MKEadmin/Vertical_farming/pcb/readme.md

Here you can find the pcb schemetics and gerber files for the Vertical Farming PCB.
