MKEadmin/Vertical_farming/Documents/STORYS.docx

STORYS

Docent

Als | Wil ik | Omdat
Docent | In python programmeren | We in de lessen alleen python gebruiken
Docent | Alles in Github | Ik overzicht wil wat de laatste versie is van de producten.
Docent | Een Planning in Trello | Het op school veel gebruikt wordt
Docent | Een werkende of deels werkende broei kast | Dat het doel van het project is
Docent | Trello gebruiken | Ik wil weten wie met wat bezig is, en wat je al af hebt

Leerling

Als | Wil ik | Omdat
Leerling | Reële opdrachten | Ik een succesvol wil afronden
Leerling | Uitdaging | Ik wil leren programmeren
Leerling | Programmering overzichtelijk hebben staan | Ik wil dat anderen de programmering kunnen inzien en veranderen
Leerling | Informatie over het project | We willen weten wat het project moet doen en waar het voor staat
Leerling | Duidelijke afspraken en communicatie | Chaos frustrerend is.
Leerling | Ruime en tijd krijgen voor het project | Ik er anders naast de lessen er niet aan kan/ mag werken
Leerling | Trello gebruiken | Ik wil weten wie met wat bezig is, en wat je al af hebt

Gebruiker

Als | Wil ik | Omdat
Gebruiker | Data online afkunnen lezen op mijn telefoon, tablet of PC | Als er te veel mensen bij de kast staan. Nog steeds eraan kunnen werken en het gebruiken
Gebruiker | Dat het water en andere aspecten vanzelf aan gaan als ik dichtbij kom of als het tijd is | Je niet op elk moment aanwezig bent en doordoor niet
Gebruiker | Een knop om alles meteen zonder spanning te zetten (Noodknop) | Ik het belangrijk vind om veilig te werken
Gebruiker | dat de algemene status van het apparaat uitgelezen kan worden | dit handig is voor: testen, documentatie en overzichtelijkheid
Gebruiker | dat het device gebruiksvriendelijk is | het product anders niet efficiënt is.
Gebruiker | Mooi/ duidelijk interface | Ik goed de status wil bekijken

Bezoeker

Als | Wil ik | Omdat
Bezoeker | Een mooie en overzichtelijke broei kas | Ik het belangrijk vind dat het er mooi en overzichtelijk uitziet
Bezoeker | Een overzichtelijke display met informatie (Data) | Ik wil gestructureerd kunnen aflezen van informatie
Bezoeker | Verzorgde uitstraling | Ik een goede indruk wil krijgen van het product

Plant

Bezoeker

Als | Wil ik | Omdat
Plant | Een goede groei omgeving | Ik sterk en gezond wil groeien
