MKEadmin/Vertical_farming/EDUTRANS Part List Vertical Farming.xlsx

 |  | PART LIST
Model: | M1
Desctiption: | Vertical Farming
School: | Da Vinci College
NUMBER | NAME | DRAWING NAME | QTY | AUTHOR | COMMERCIAL REF. | DESCRIPTION | Website | Cost
1 | Alu profile | part of assembly | 16 | DVC | 222-000 | BSB 30x30N L= 2000 mm | https://www.tech-specialist.com/nl/ | €300.00
2 | BSB 8 Central connector 90 | NA | 32 | commercial | 1007723 | BSB 8 Central connector 90 degrees | https://www.tech-specialist.com/nl/ | €64.00
3 | BSB 8 Central connector 0 | NA | 32 | commercial | 1007719 | BSB 8 Central connector 0 degrees | https://www.tech-specialist.com/nl/ | €64.00
4 | BSB T-slot snap-in nut steel with cam and leaf spring | NA | 60 | commercial | 1008412 | BSB T-slot snap-in nut steel with cam and leaf spring | https://www.tech-specialist.com/nl/ | €120.00
5 | BSB Corner block connector incl. cap | NA | 8 | commercial | 1024293 | BSB Corner block connector incl. cap | https://www.tech-specialist.com/nl/ | €68.00
6 | BSB clamping rubber | NA | 200m | commercial | 1019322 | BSB clamping rubber | https://www.tech-specialist.com/nl/ | €200.00
7 | BSB Plastic Hinge | NA | 8 | commercial | 1008598 | BSB Plastic Hinge | https://www.tech-specialist.com/nl/ | €25.00
8 | Wheel Swivel | NA | 2 | Blickle | 294926 | Swivel castors with polyurethane tread with brake | https://www.blickle.nl/ | €70.00
9 | Fixed-wheel | NA | 2 | Blickle | 297119 | Fixed-wheel castor with polyurethane tread | https://www.blickle.nl/ | €35.00
10 | Knob | NA | 8 | random | 3036-S | M8x1,25 internal thread | NA | €32.00
11 | Polucarbonaat sheets 5 mm | part of assembly | 16 m2 | random | NA | clear and white, shape and size acc.to drawings | NA | €960.00
12 | Mist Nozzles | NA | 8 | Ounona by Amazon | B07DRFZWYW | Adjustable sprinkler, copper, with capillary effect | https://www.amazon.nl/Verstelbare-sproeikoper-capillaire-instelbare-druppelsysteem/dp/B07DRFZWYW | €16.00
13 | Hose 8 and 12 mm | NA | 2 x 50 m | commercial | NA | water hose for nozzles | NA | €175.00
14 | Connectors for waterhose | NA | 50 | commercial | NA | connectors 8 en 12 mm, collection | highly available on the internet | €150.00
15 | Shut-off valve | NA | 8 | Festo | HE-2-QS-8 | connector with shut-off function | www.festo.com | €90.00
16 | Main valve | NA | 1 | JP Fluid Control | ST-SA012B105F-012DC | Electric Solenoid Valve, G 1/2 " 12V NC Copper | https://tameson.nl/kleppen/magneetventiel/2-weg/messing/st-sa012b105f-012dc-magneetventiel-2weg-012inch-messing-0p0-10bar-fkm.html | €47.00
17 | Valve 2-2 per layer | NA | 4 | Acogedor by Amazon | 747333445732 | Electric Solenoid Valve, G 1 / 2" 12V NC plastic | https://www.amazon.nl/Valve%EF%BC%8CMagneetventiel%EF%BC%8Celektrisch-magneetventiel-kunststof-elektrisch-waterafgifte/dp/B07Q5ZZBWK | €36.00
18 | pressure gauge | NA | 1 | commercial | NA | Pressure cauge 0-10 bar | highly available on the internet | €15.00
19 | LED Tube | NA | 4 | Hortilight | LT-KVHL30LT | 30W waterproof LED Tube Grow | https://www.kweekverlichting.nl/led-kweeklampen/strips/led-tube-30w-bloei | €360.00
20 | Axial fan | NA | 4 | Farnel | MC001616 | Axial Fan, IP68, 12 V, DC, 80 mm, 25 mm, 41 cu.ft/min, 69.7 m³/h | https://nl.farnell.com/multicomp/mc001616/axial-fan-80mm-12vdc-41cfm-33dba/dp/2759177 | €86.00
21 | Cable glands etc for electrical wirering | NA | 30 | commercial | several types | for hoses to keep it watertight | highly available on the internet | €30.00
22 | Arduino 1 | NA | 1 | commercial | Arduino 1 | controler | highly available on the internet | €25.00
23 | Wifi receiver | NA | 1 | commercial | Arduino-esp8266 | to communicate with the www | highly available on the internet | €4.00
24 | Adafruit Proto Screw Shield | NA | 1 | commercial | NA | to add to Arduino | https://www.kiwi-electronics.com/en/adafruit-proto-shield-for-arduino-kit-stackable-version-r3-2568 | €11.00
25 | Relais module for Arduino | NA | 1 | commercial | TRU COMPONENTS TC-9445344 | 16 relais on 1 board | highly available on the internet | €30.00
26 | Power supply | NA | 1 | commercial | NA | Power Supply 12V DC 150W 15A | highly available on the internet | €20.00
27 | Gas sensor | NA | 1 | commercial | MQ-135 | to messure Carbon Dioxide | highly available on the internet | €5.00
28 | Temp and Humidity sensor | NA | 1 | commercial | DHT22 | to messure Temp and Humidity | highly available on the internet | €9.00
29 | Display | NA | 1 | Nextion | NX4024T032 | display 3,2 inch | NX4024T032 (IM150416005) (https://www.itead.cc/nextion-nx4024t032.html) | €45.00
 |  |  |  |  |  |  | Total | €3092.00
