MKEadmin/Vertical_farming/case/vf-case.3mf

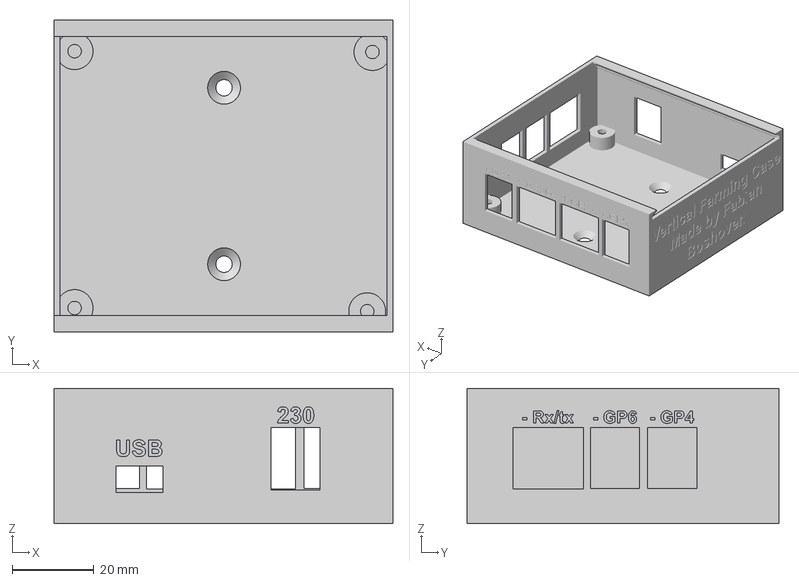
[picture p2: CAD file, 2023-11-05]
case/vf-case.3mf
82.7 x 76.1 x 33.0 mm
