MKEadmin/Vertical_farming/case/lidv1.3mf

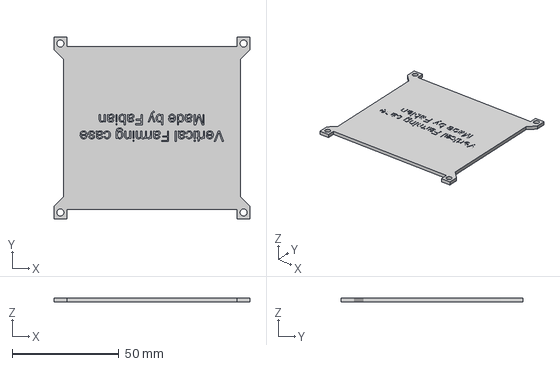
[picture p3: CAD file, 2023-11-05]
case/lidv1.3mf
91.7 x 85.1 x 2.00 mm
