MKEadmin/Vertical_farming/(list of files, cad)

Other CAD files:
pcb/Vertical_farming_pcb.f3z
