MKEadmin/Vertical_farming/pcb/Schematic v17.pdf

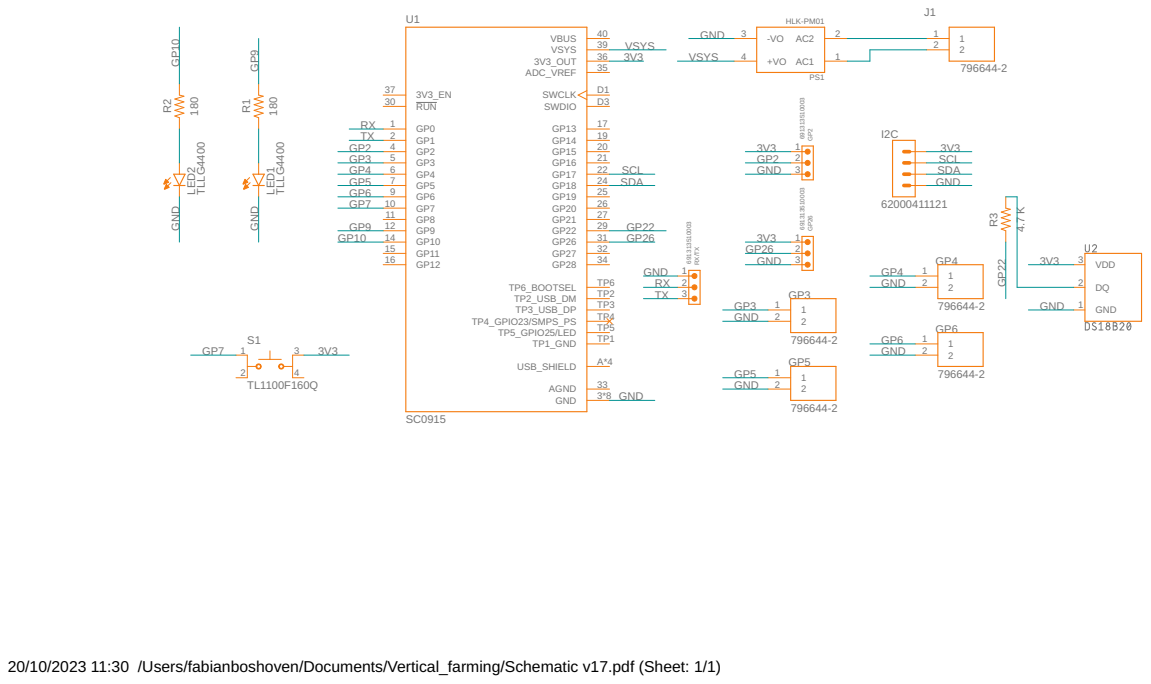
[picture p4: page 1]

20/10/2023 11:30 /Users/fabianboshoven/Documents/Vertical_farming/Schematic v17.pdf (Sheet: 1/1)
