MKEadmin/Vertical_farming/e-plan tekeningen v2.pdf

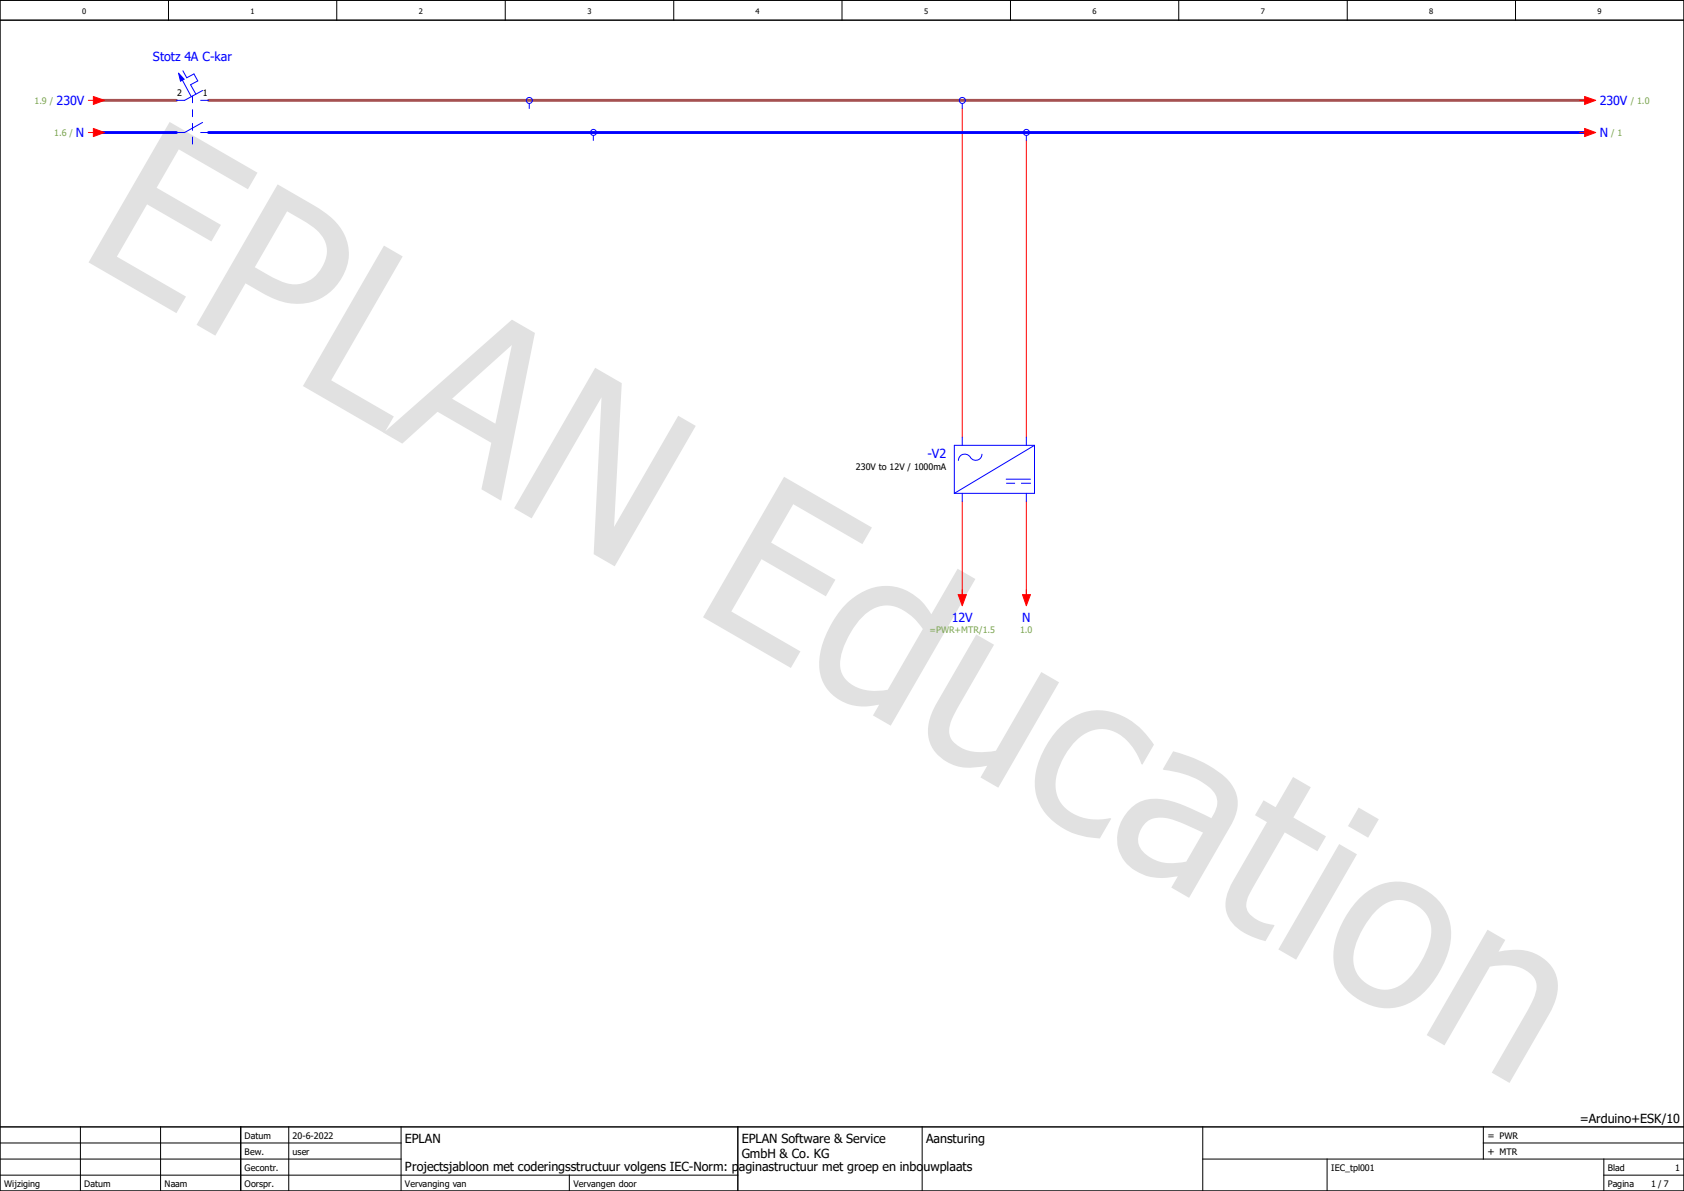
[picture p5: page 1]
=Arduino+ESK/10; Stotz 4A C-kar; 12V =PWR+MTR/1.5

20-6-2022 | EPLAN Projectsjabloon met coderingsstructuur volgens IEC-Norm: paginastructuur met groep en inbouwplaats | EPLAN Software & Service GmbH & Co. KG | Aansturing | = PWR

Bew. | user | | | | + MTR
Gecontr. | | | | | IEC_tpl001 | Blad

Wijziging | Datum | Naam | Oorspr. | | Vervanging van | Vervangen door | | | | Pagina 1 / 7

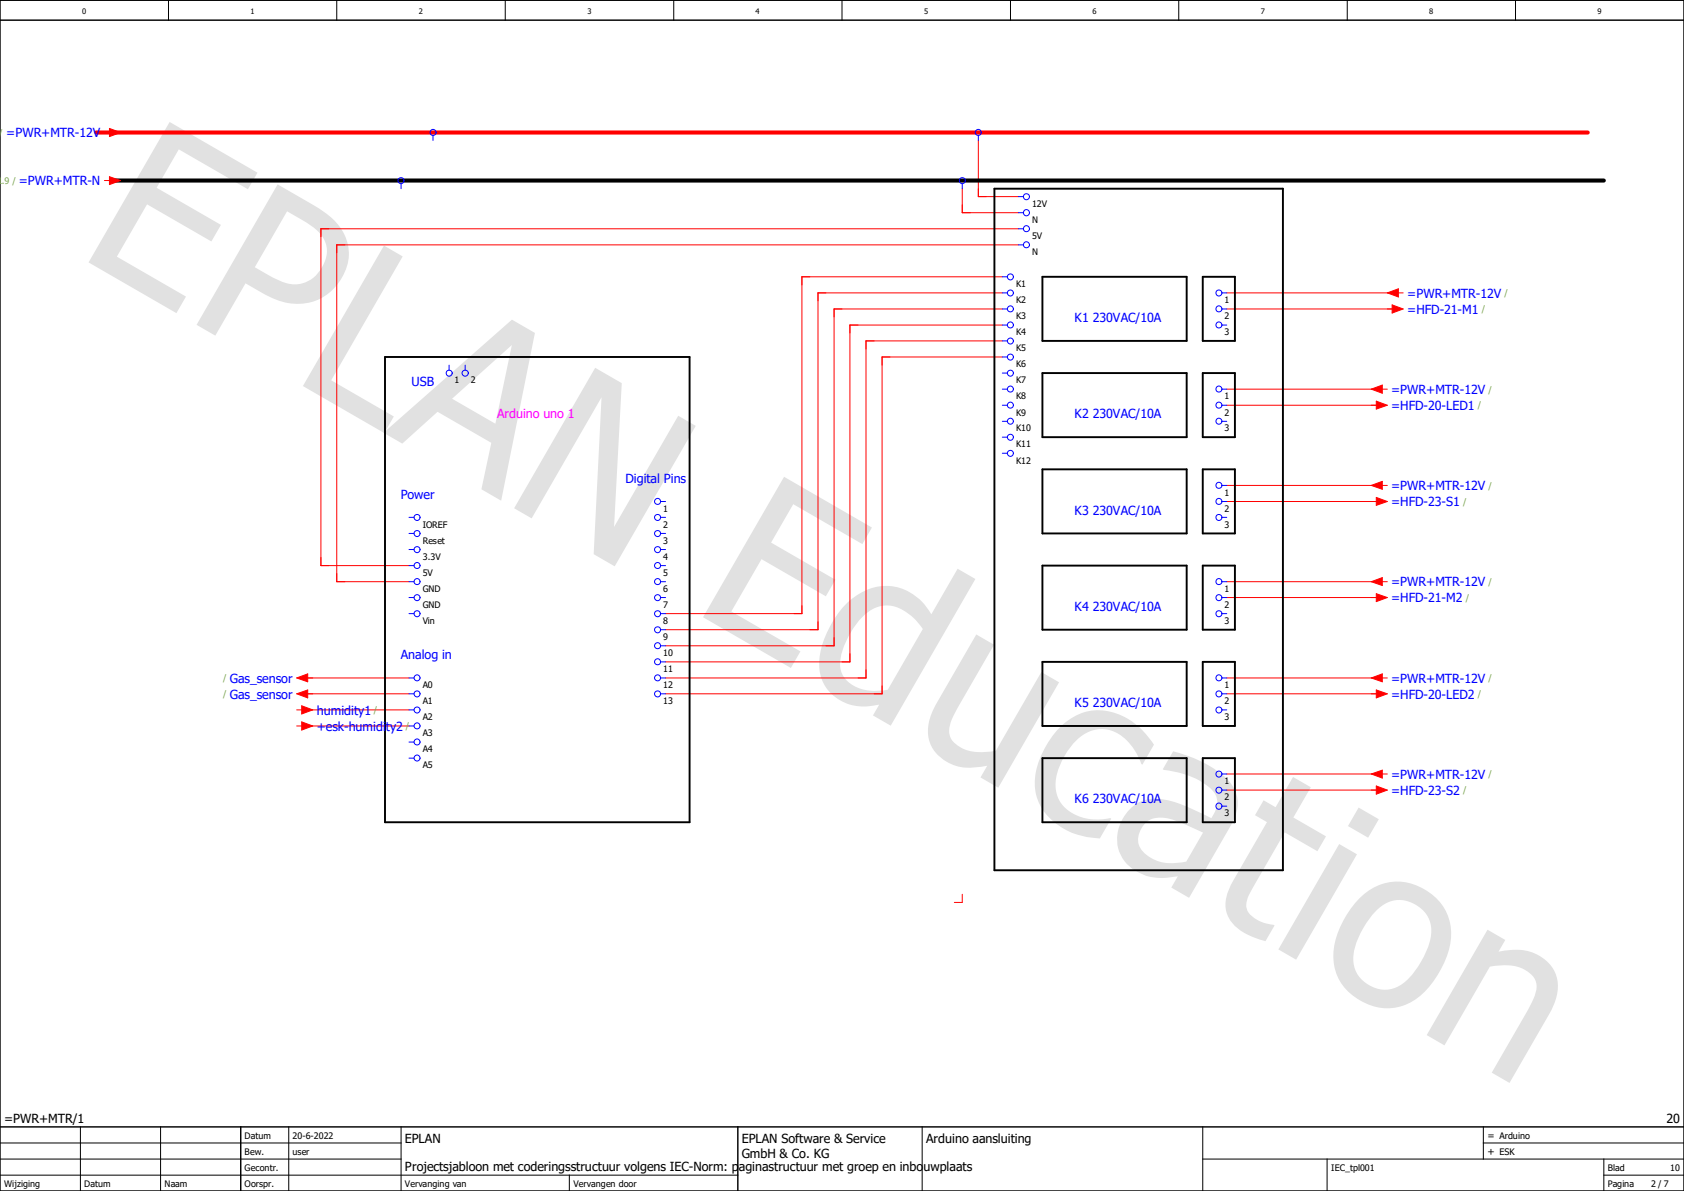
[picture p6: page 2]
=PWR+MTR/1; Arduino ESK; Arduino aansluiting; K1 230VAC/10A; K2 230VAC/10A; K3 230VAC/10A; K4 230VAC/10A; Digital Pins; Analog in; Power; K5 230VAC/10A; K6 230VAC/10A; Arduino uno 1; USB; IOREF Reset 3.3V 5V GND GND Vin; / =PWR+MTR-12V; / =PWR+MTR-N; =PWR+MTR-12V /; / Gas_sensor / Gas_sensor; =HFD-21-M1 /; =HFD-20-LED1 /; =HFD-23-S1 /; =HFD-21-M2 /; =HFD-20-LED2 /; =HFD-23-S2 /; +esk-humidity2 /; humidity1 /

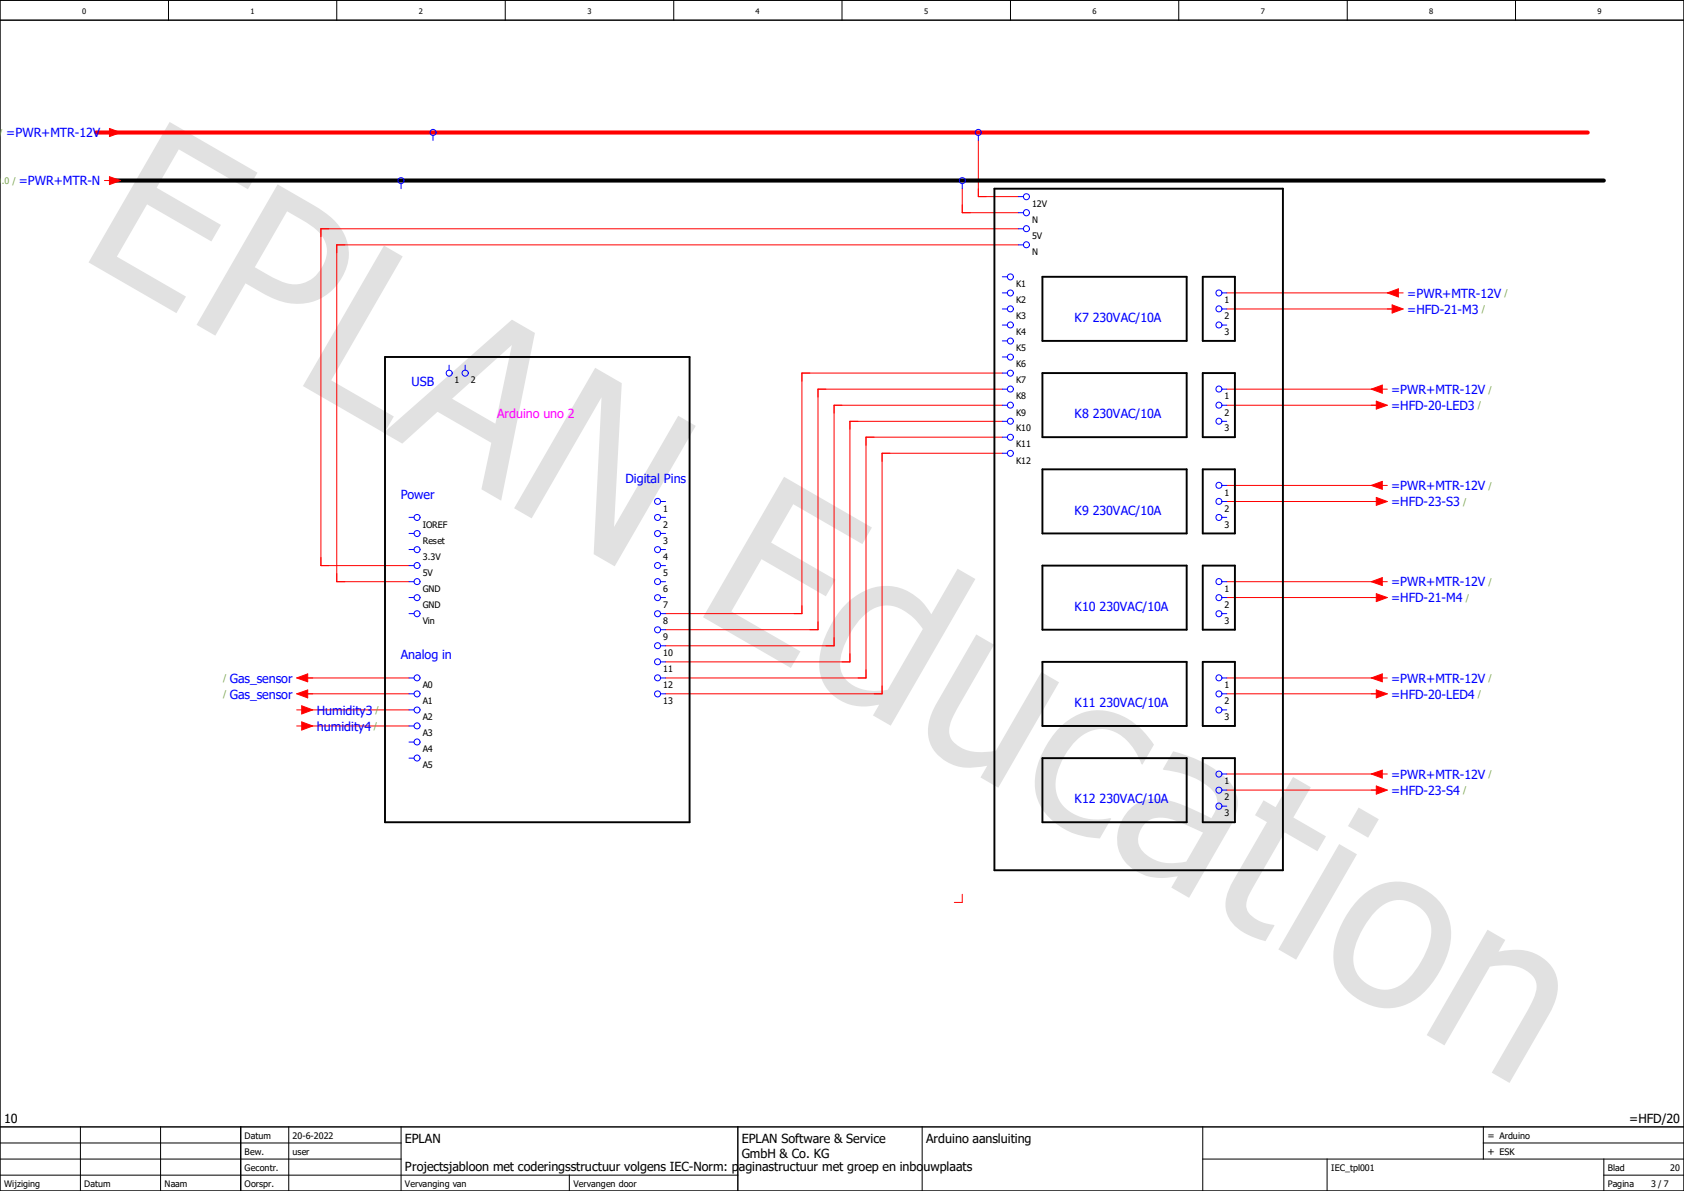
[picture p7: page 3]
Arduino; Arduino aansluiting; =HFD/20; K7 230VAC/10A; K8 230VAC/10A; K9 230VAC/10A; K10 230VAC/10A; Digital Pins; Analog in; Power; K11 230VAC/10A; K12 230VAC/10A; Arduino uno 2; USB; IOREF Reset 3.3V 5V GND GND Vin; / =PWR+MTR-12V; / =PWR+MTR-N; =PWR+MTR-12V /; / Gas_sensor / Gas_sensor; =HFD-21-M3 /; =HFD-20-LED3 /; =HFD-23-S3 /; =HFD-21-M4 /; =HFD-20-LED4 /; =HFD-23-S4 /; humidity4 /; Humidity3 /

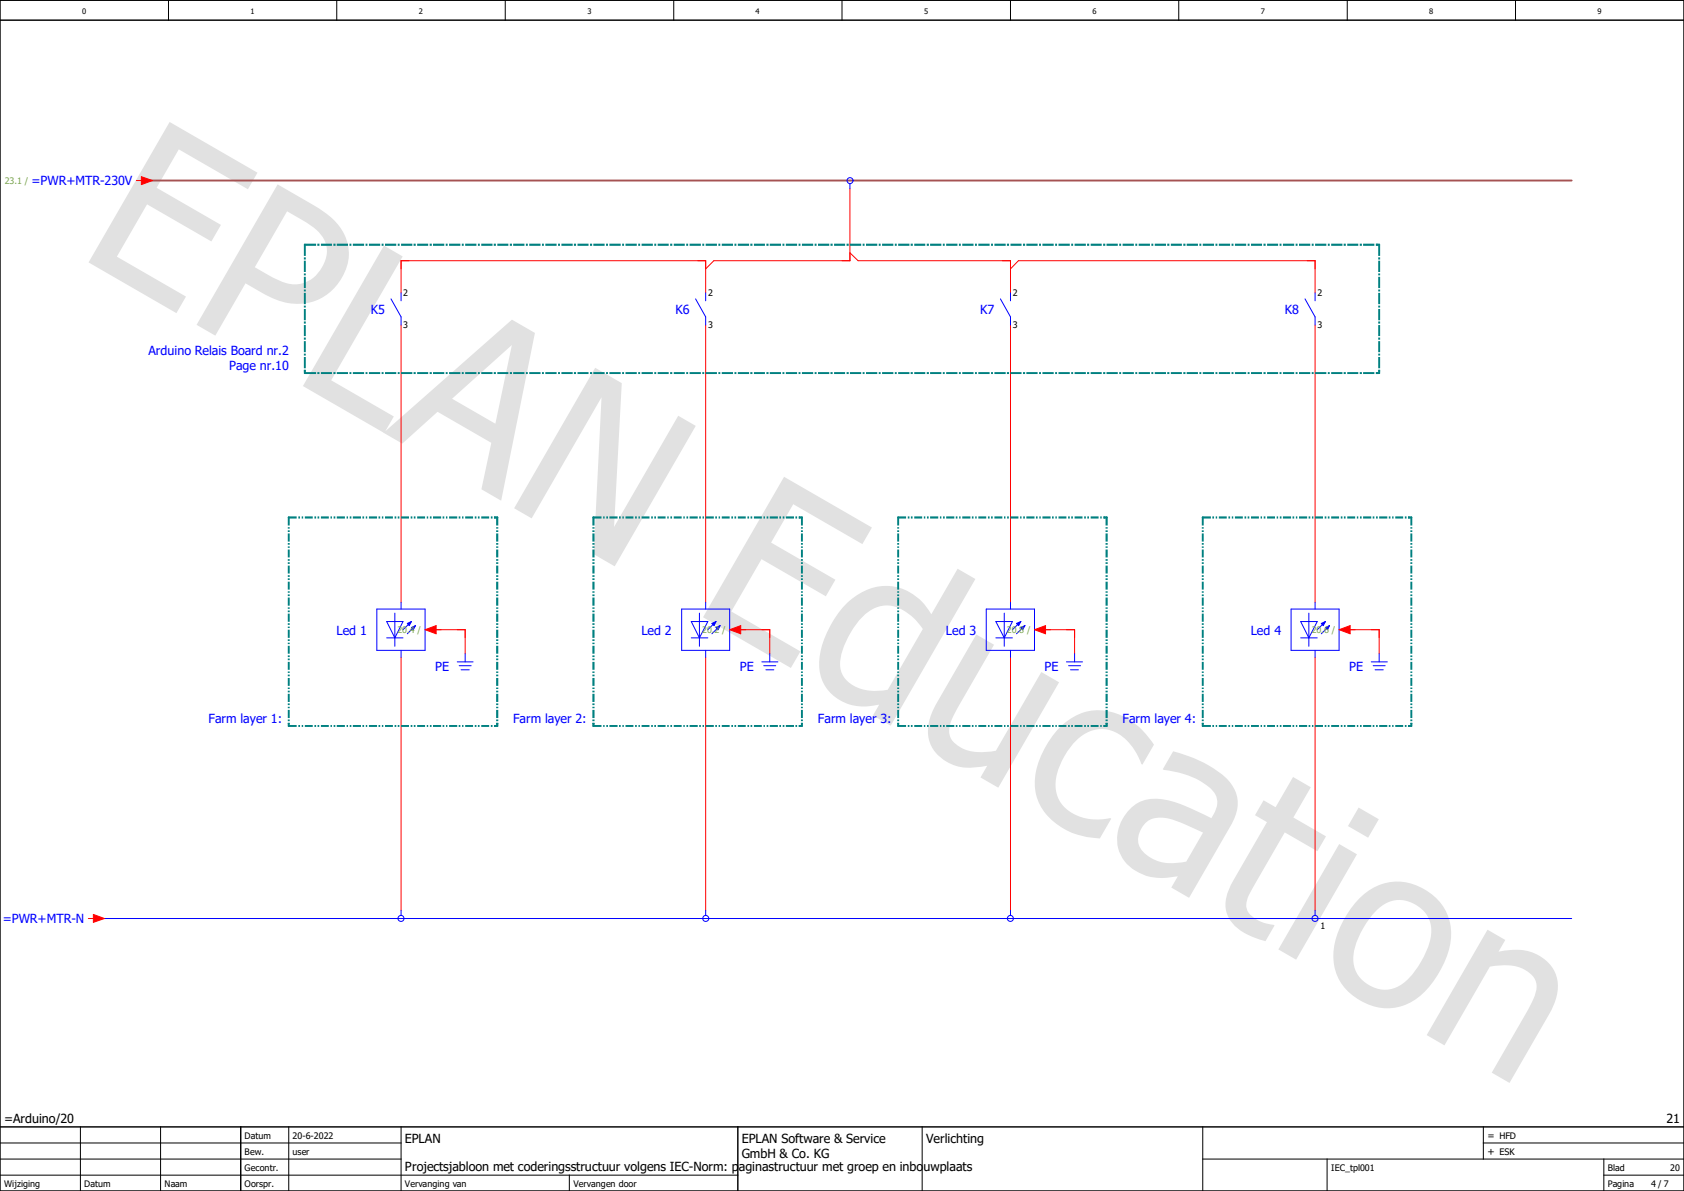
[picture p8: page 4]
=Arduino/20; HFD; Verlichting; Page nr.10; Farm layer 1:; Farm layer 2:; Farm layer 3:; Farm layer 4:; Led 1; Led 2; Led 3; Led 4; =PWR+MTR-N; 23.1 / =PWR+MTR-230V

Arduino Relais Board nr.2

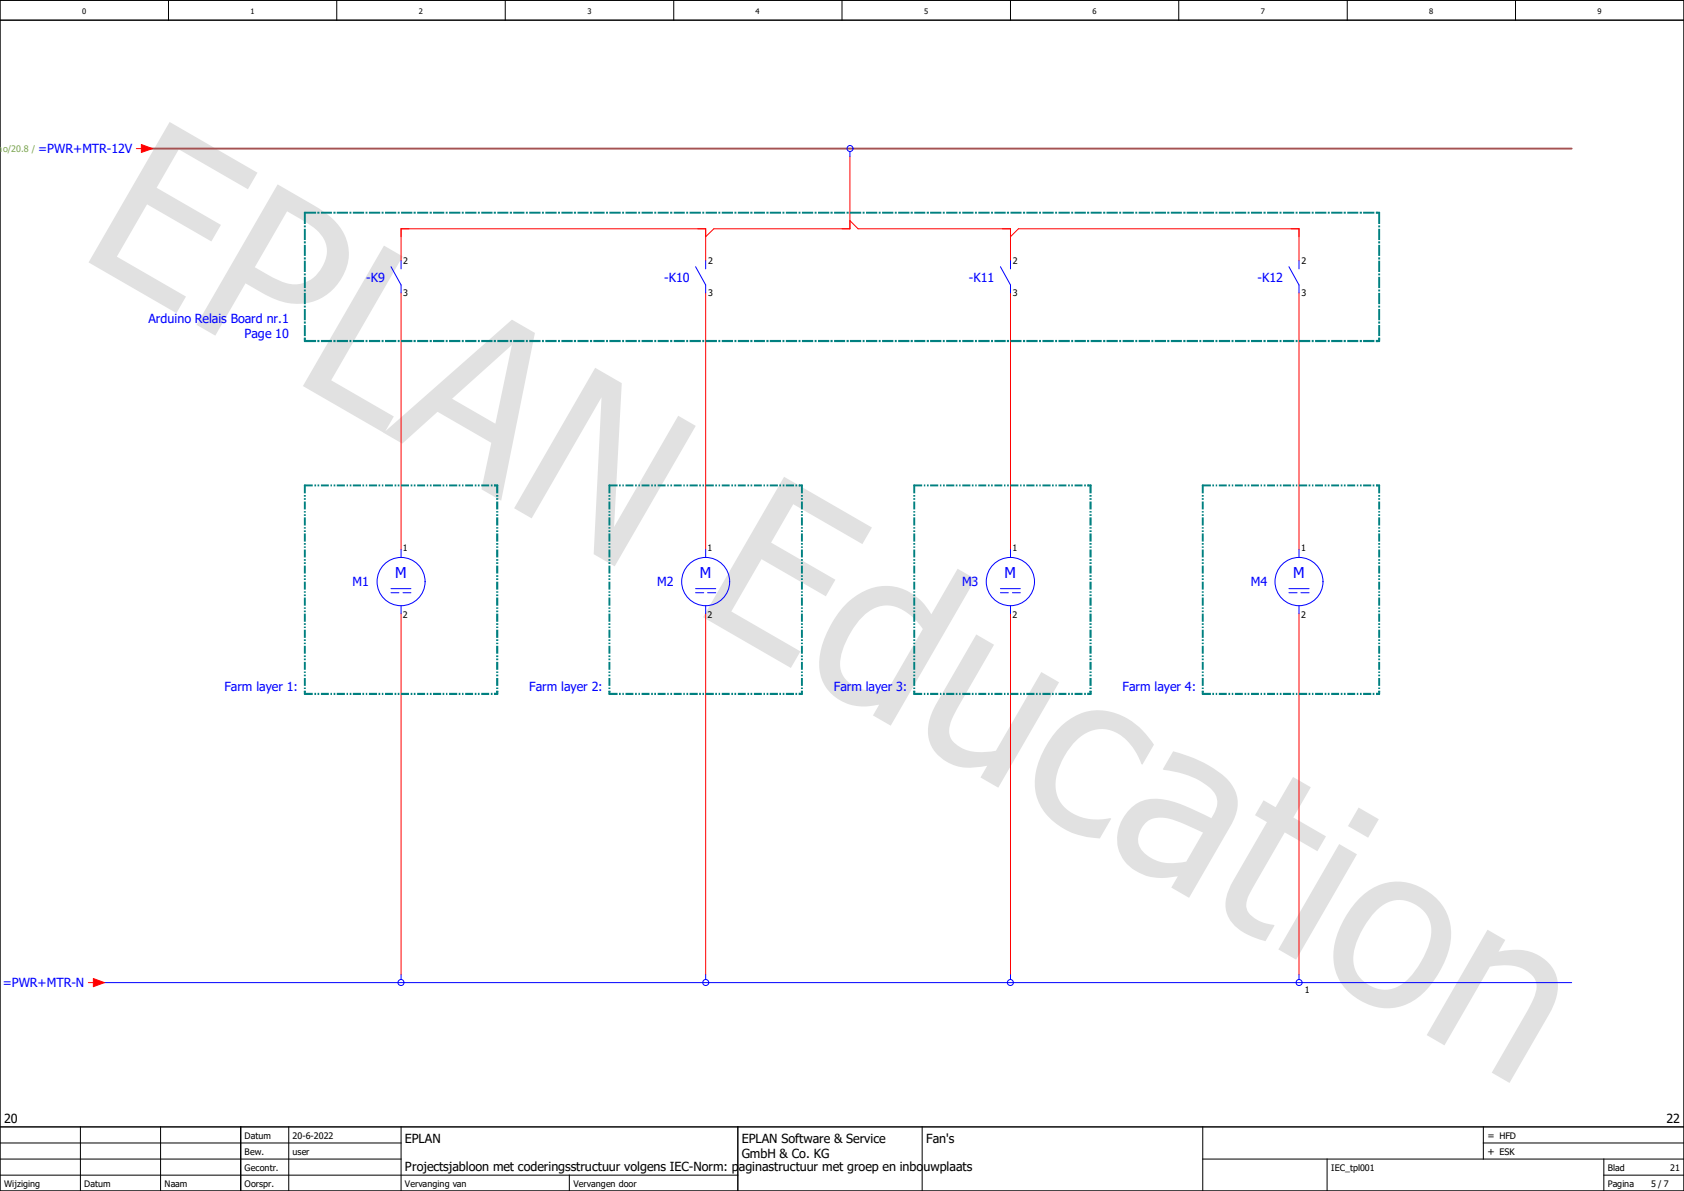
[picture p9: page 5]
Fan's; Page 10; Farm layer 1:; Farm layer 2:; Farm layer 3:; Farm layer 4:; =PWR+MTR-N; / =PWR+MTR-12V

Arduino Relais Board nr.1

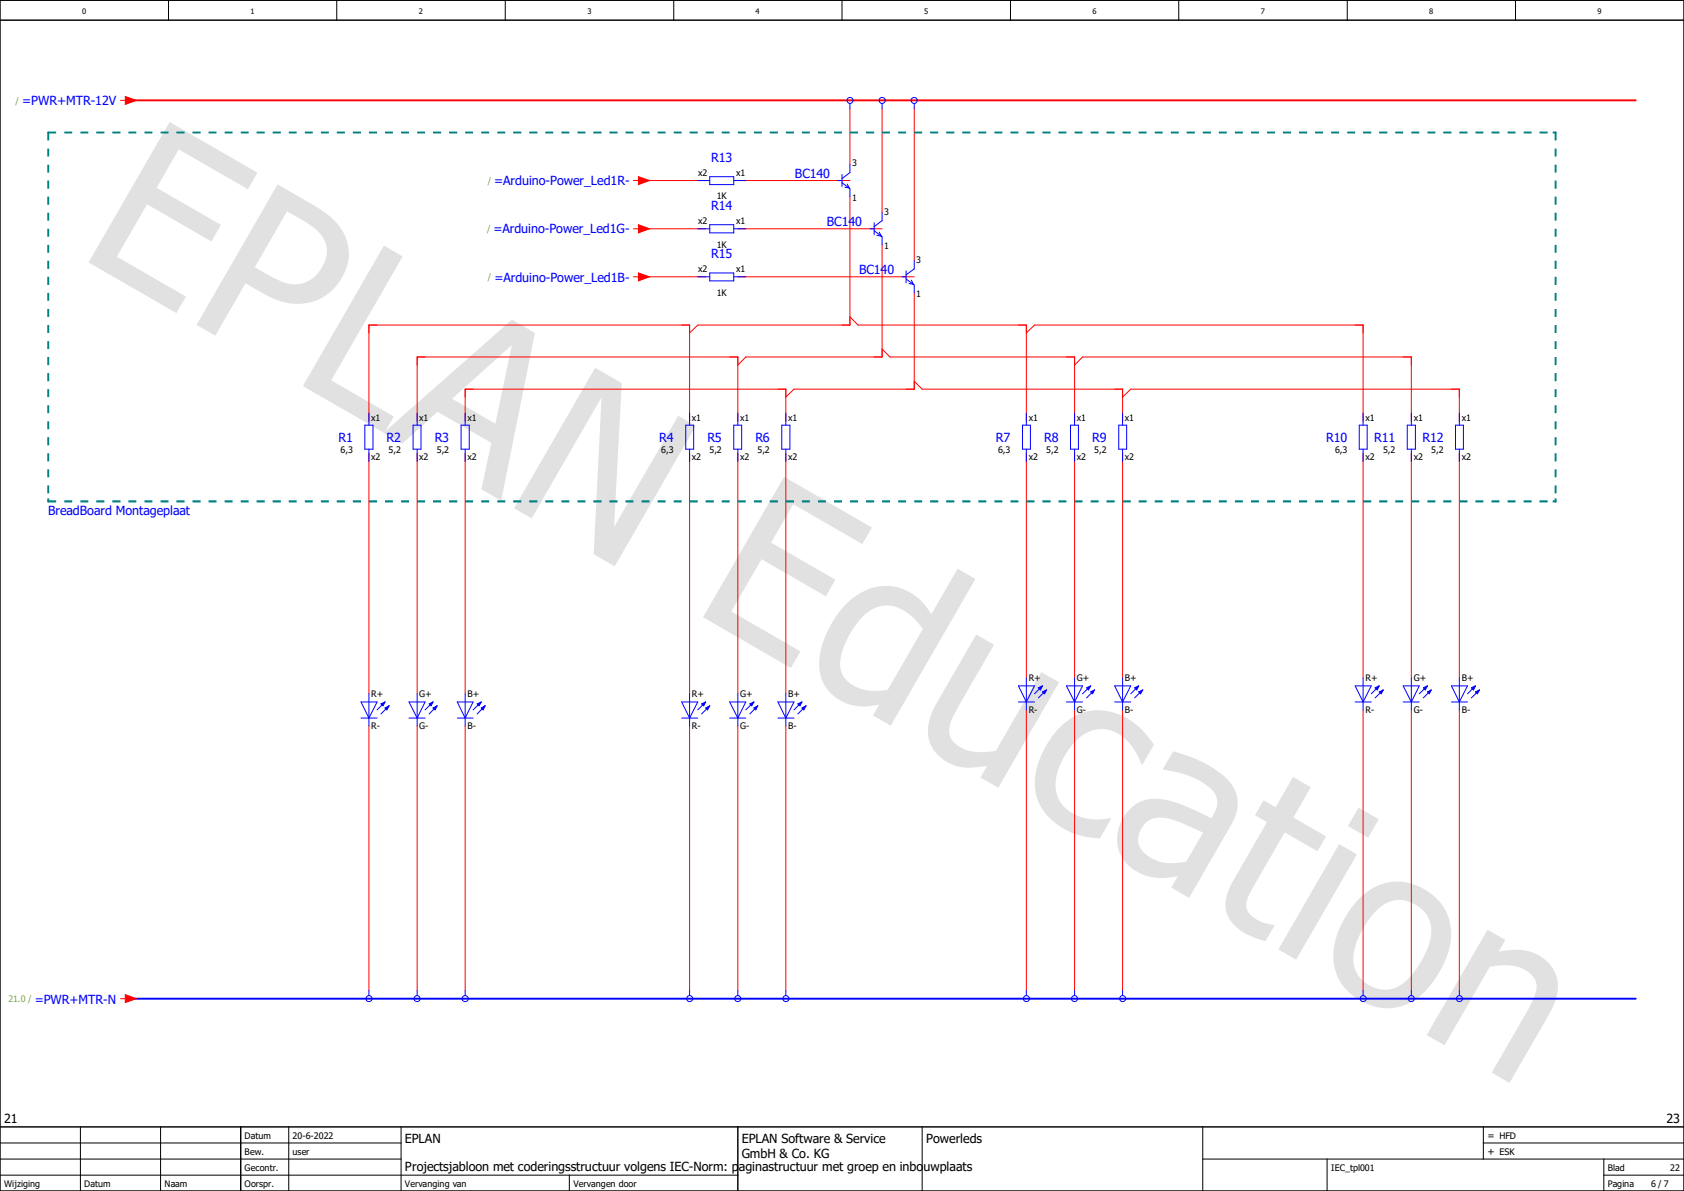
[picture p10: page 6]

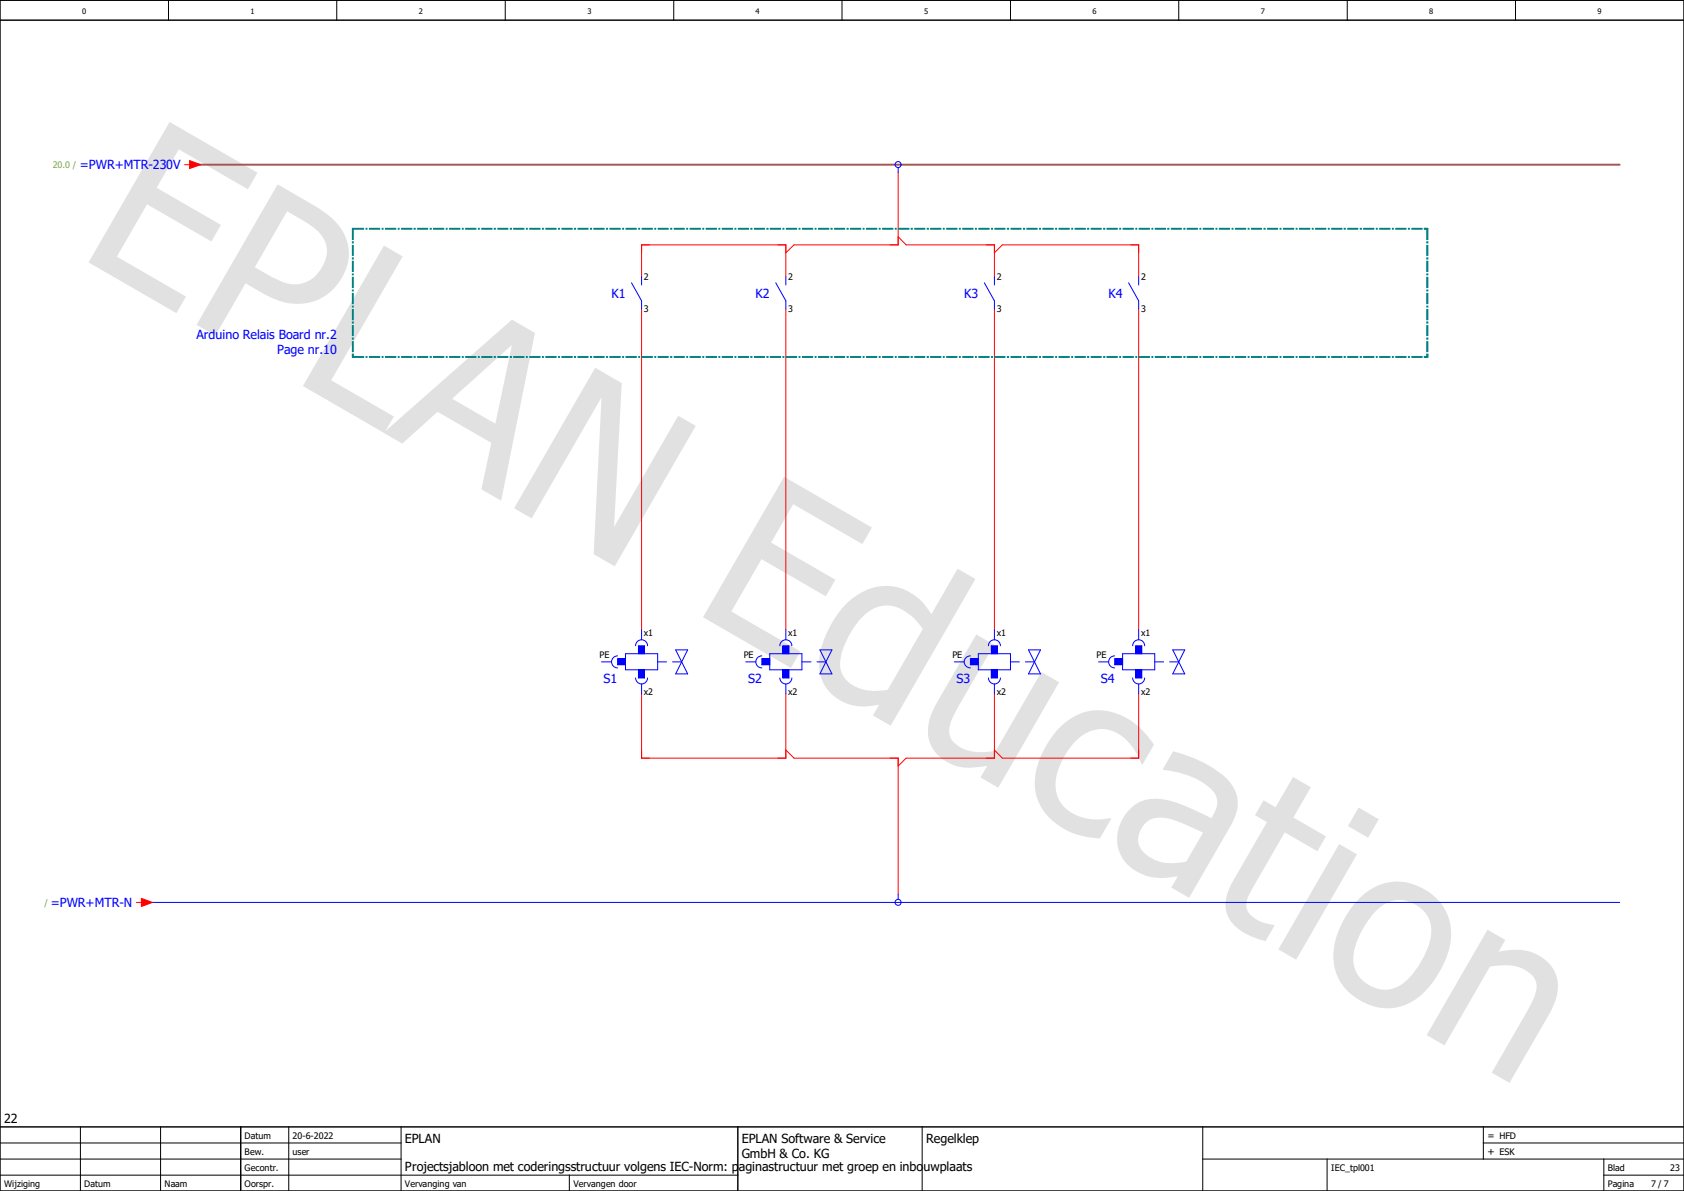
[picture p11: page 7]
Regelklep; Page nr.10; / =PWR+MTR-N; 20.0 / =PWR+MTR-230V

Arduino Relais Board nr.2
