MKEadmin/Vertical_farming/E-plan tekeningen.pdf

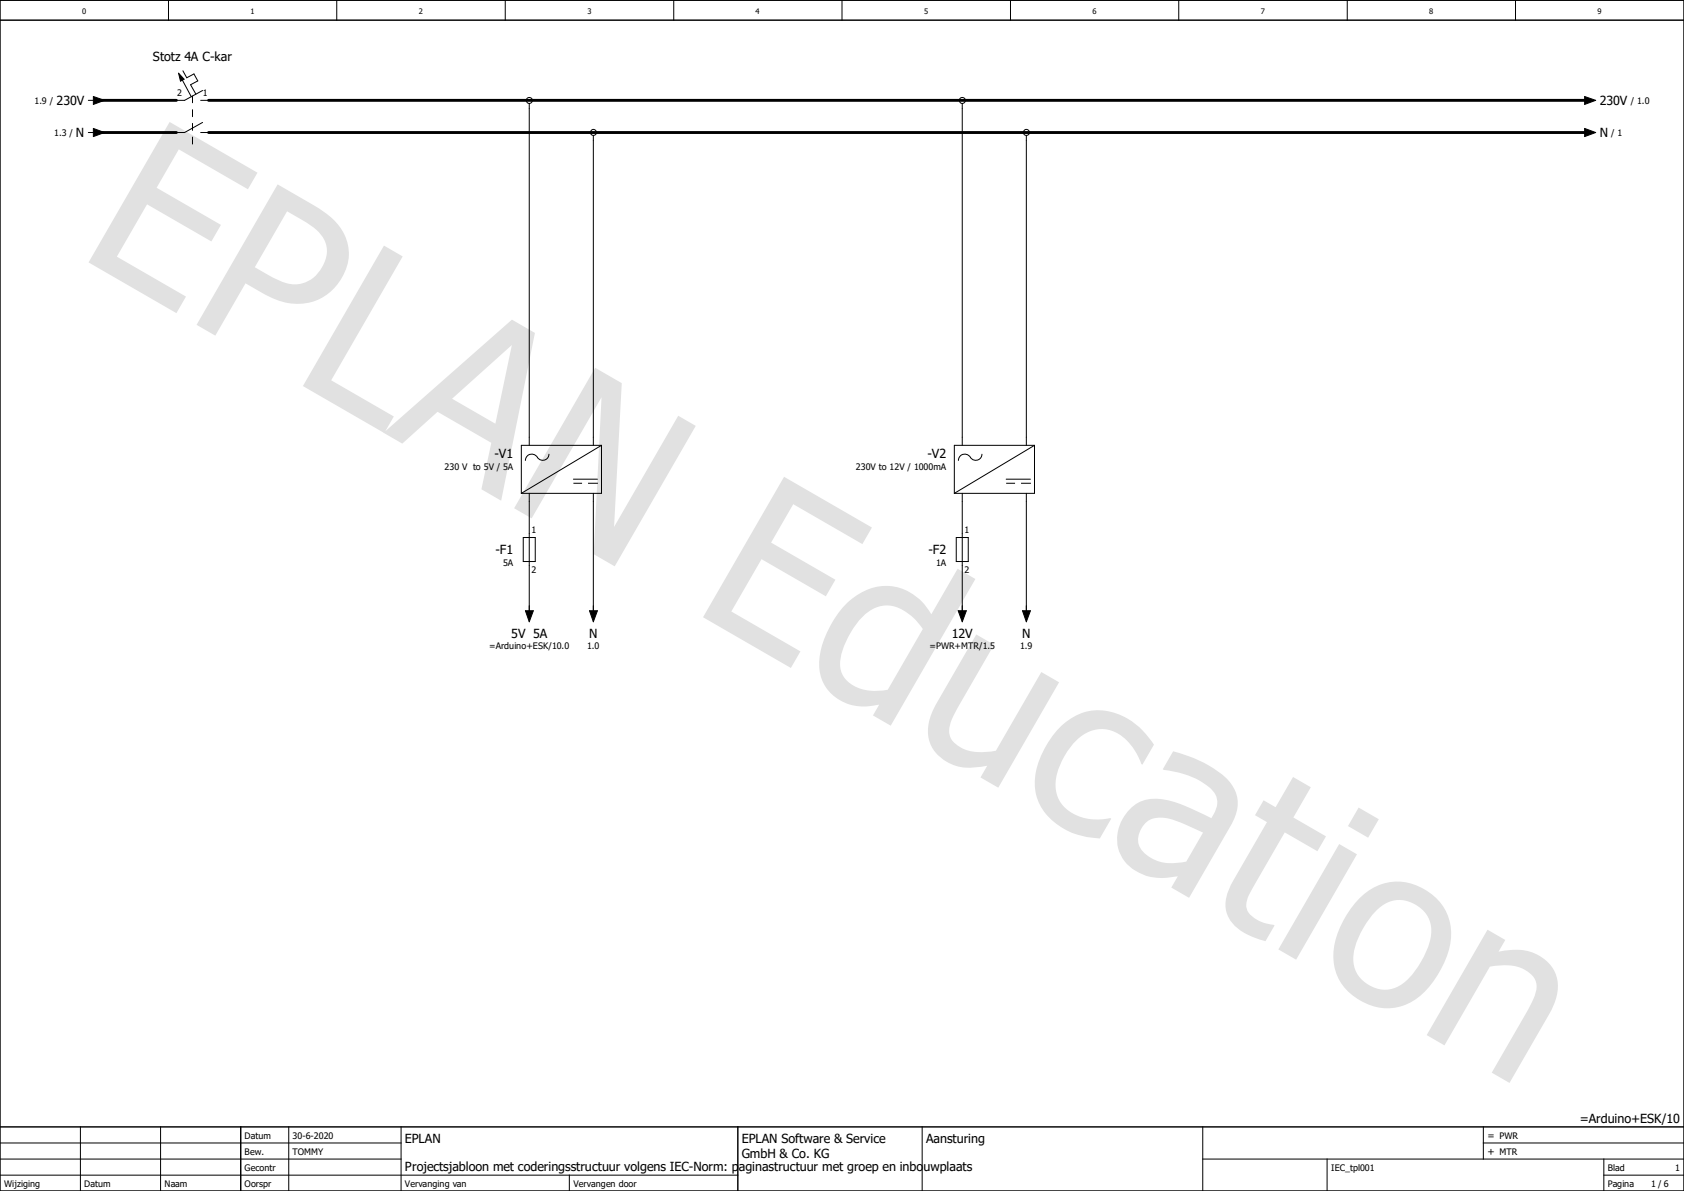
[picture p12: page 1]
=Arduino+ESK/10; Stotz 4A C-kar; 5V 5A =Arduino+ESK/10.0; 12V =PWR+MTR/1.5

30-6-2020 | EPLAN Projectsjabloon met coderingsstructuur volgens IEC-Norm: paginastructuur met groep en inbouwplaats | EPLAN Software & Service GmbH & Co. KG | Aansturing | = PWR

Bew. | TOMMY | | | | + MTR
Gecontr | | | | | IEC_tpl001 | Blad

Wijziging | Datum | Naam | Oorspr | | Vervanging van | Vervangen door | | | | Pagina 1 / 6

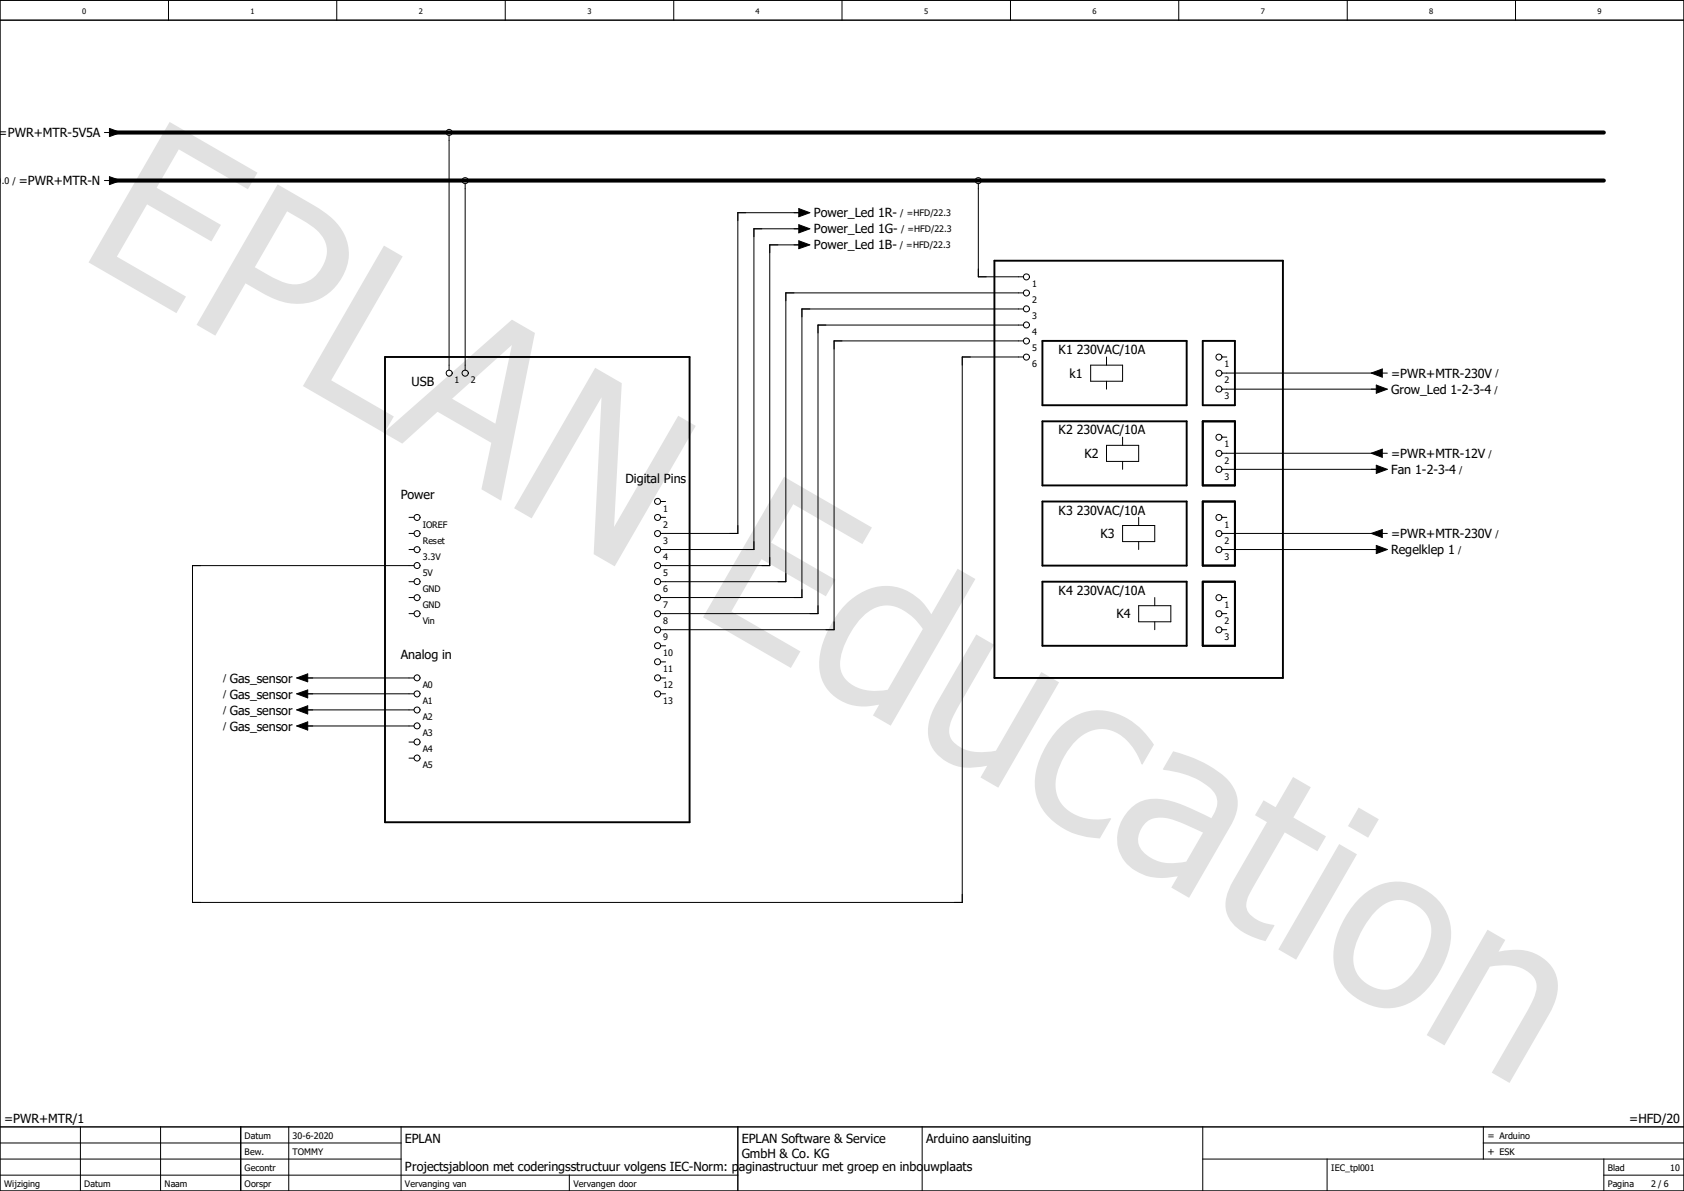
[picture p13: page 2]
=PWR+MTR/1; Arduino ESK; Arduino aansluiting; =HFD/20; K1 230VAC/10A; K2 230VAC/10A; K3 230VAC/10A; K4 230VAC/10A; Digital Pins; Analog in; Power; USB; IOREF Reset 3.3V 5V GND GND Vin; =PWR+MTR-5V5A; / =PWR+MTR-N; Fan 1-2-3-4 /; =PWR+MTR-230V /; / Gas_sensor / Gas_sensor / Gas_sensor / Gas_sensor; Power_Led 1B- / =HFD/22.3; Power_Led 1G- / =HFD/22.3; Power_Led 1R- / =HFD/22.3; Grow_Led 1-2-3-4 /; =PWR+MTR-12V /; =PWR+MTR-230V / Regelklep 1 /

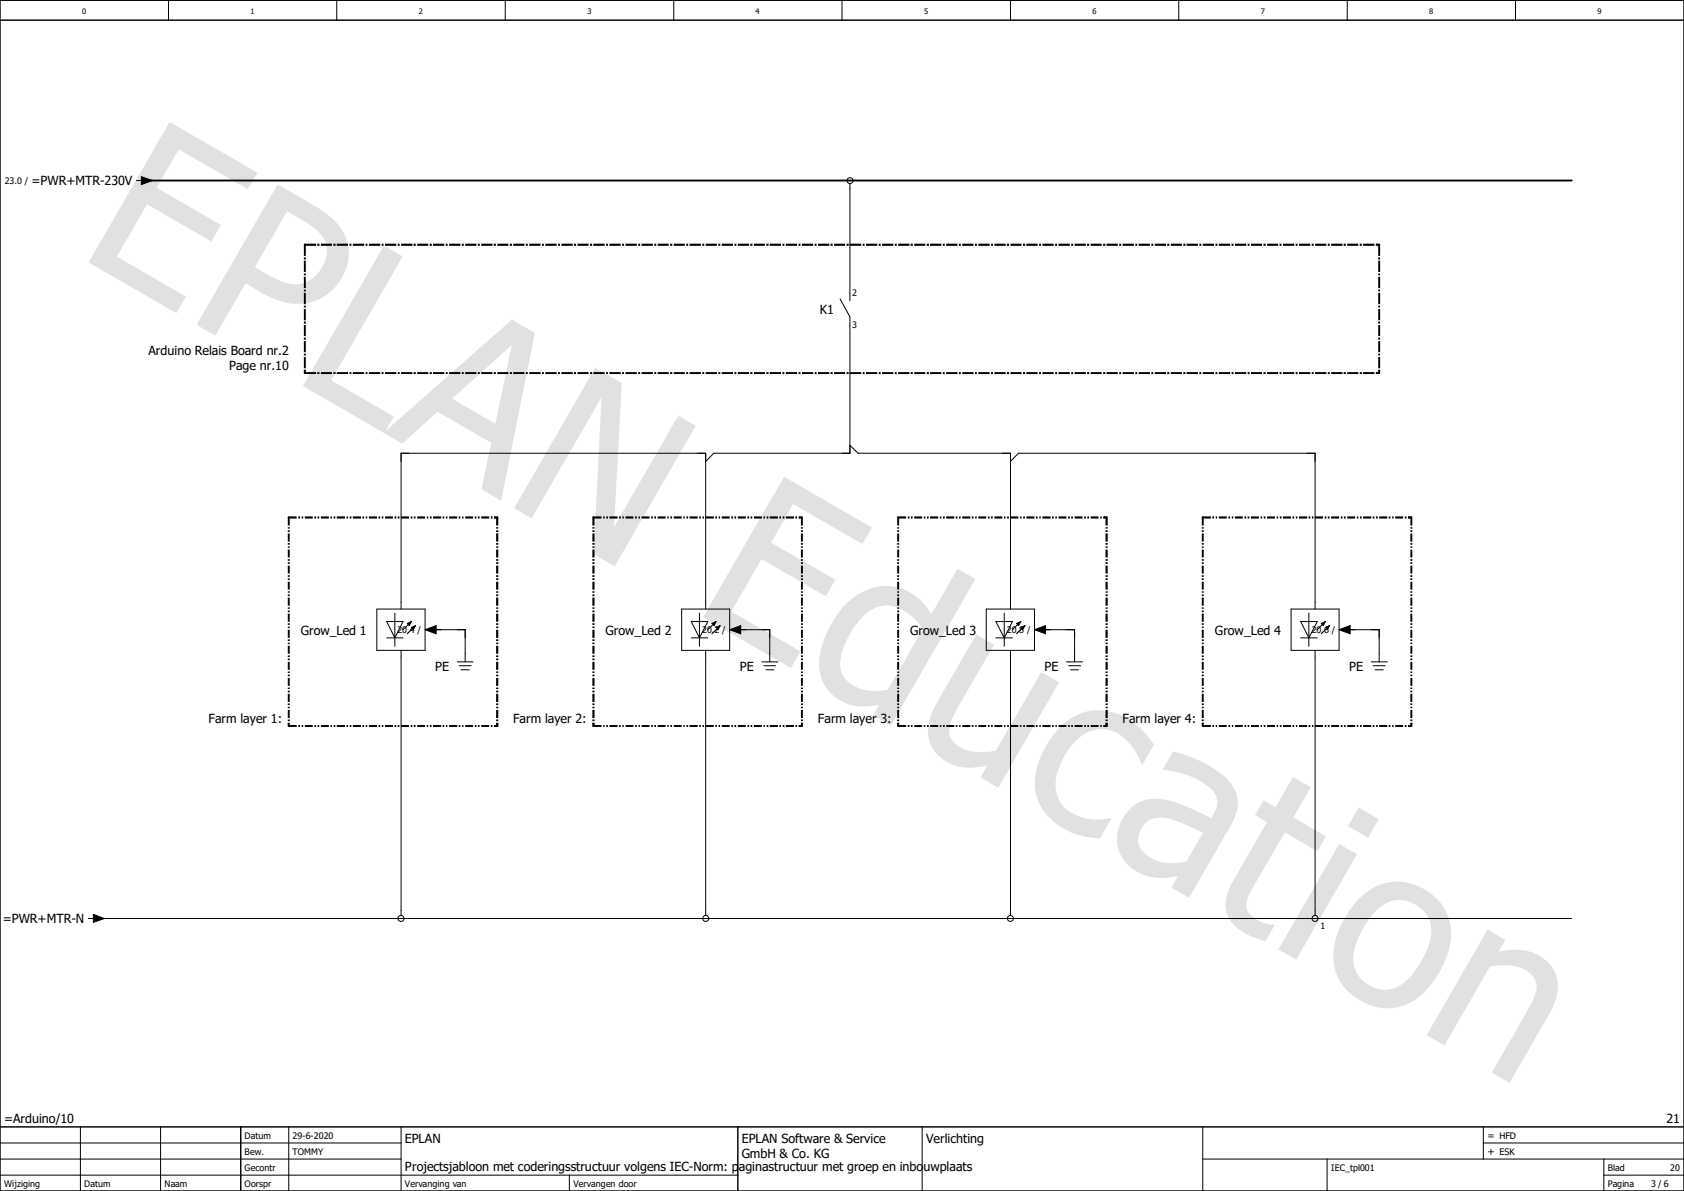
[picture p14: page 3]
=Arduino/10; HFD; Verlichting; EPLAN Software & Service; Page nr.10; Farm layer 1:; Farm layer 2:; Farm layer 3:; Farm layer 4:; Grow_Led 1; Grow_Led 2; Grow_Led 3; Grow_Led 4; =PWR+MTR-N; 23.0 / =PWR+MTR-230V

Arduino Relais Board nr.2

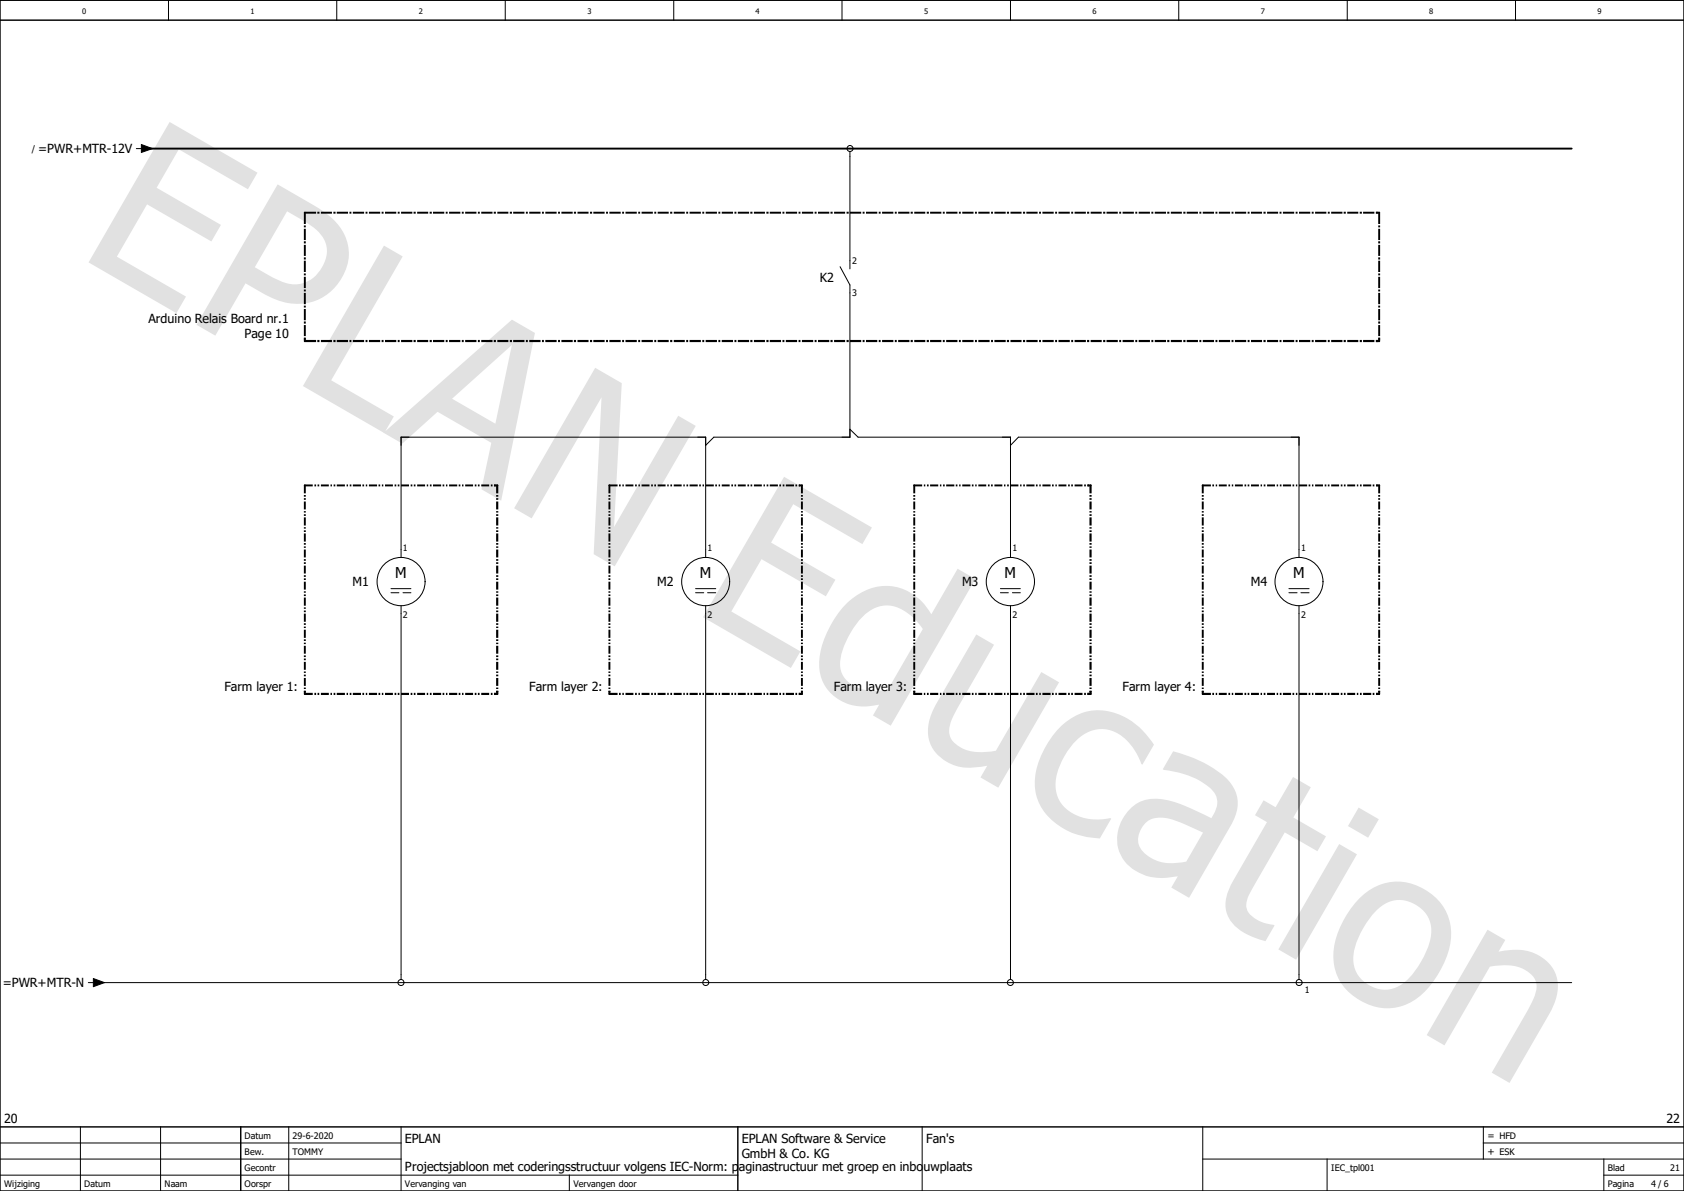
[picture p15: page 4]
Fan's; Page 10; Farm layer 1:; Farm layer 2:; Farm layer 3:; Farm layer 4:; =PWR+MTR-N; / =PWR+MTR-12V

Arduino Relais Board nr.1

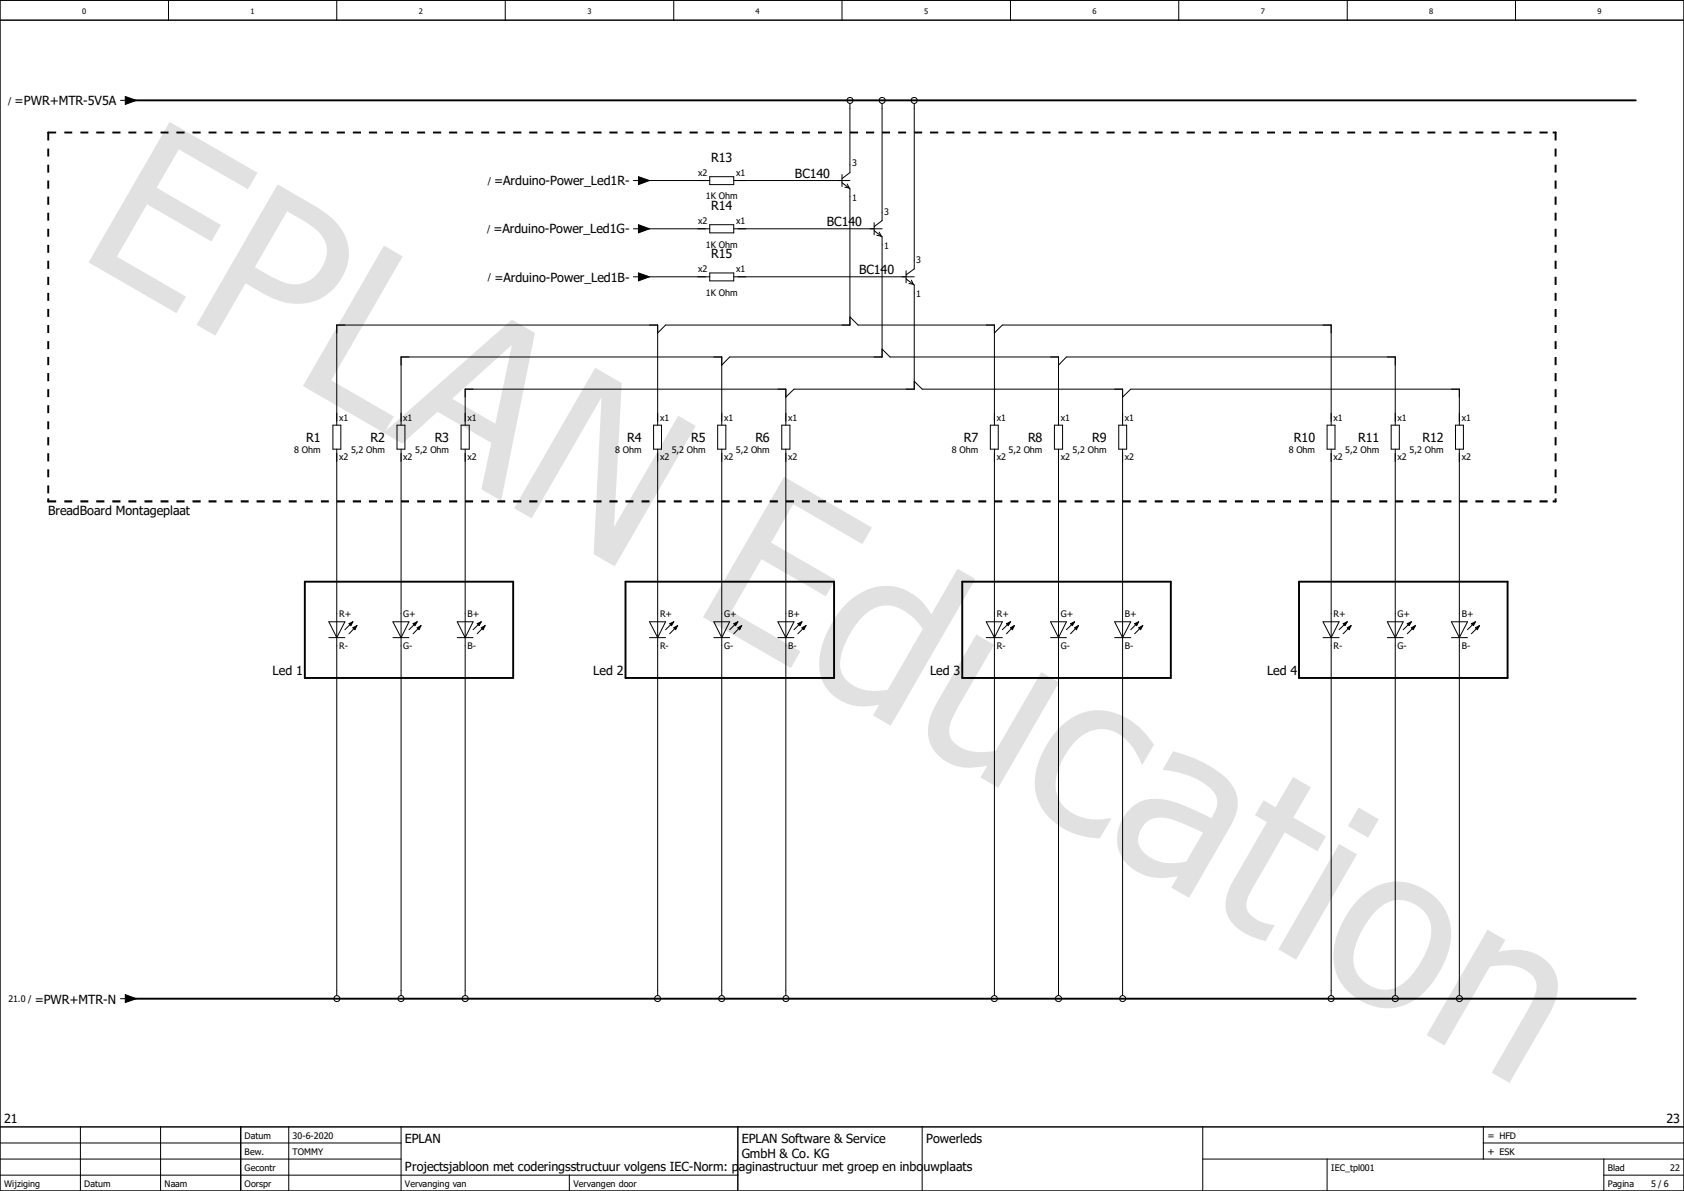
[picture p16: page 5]

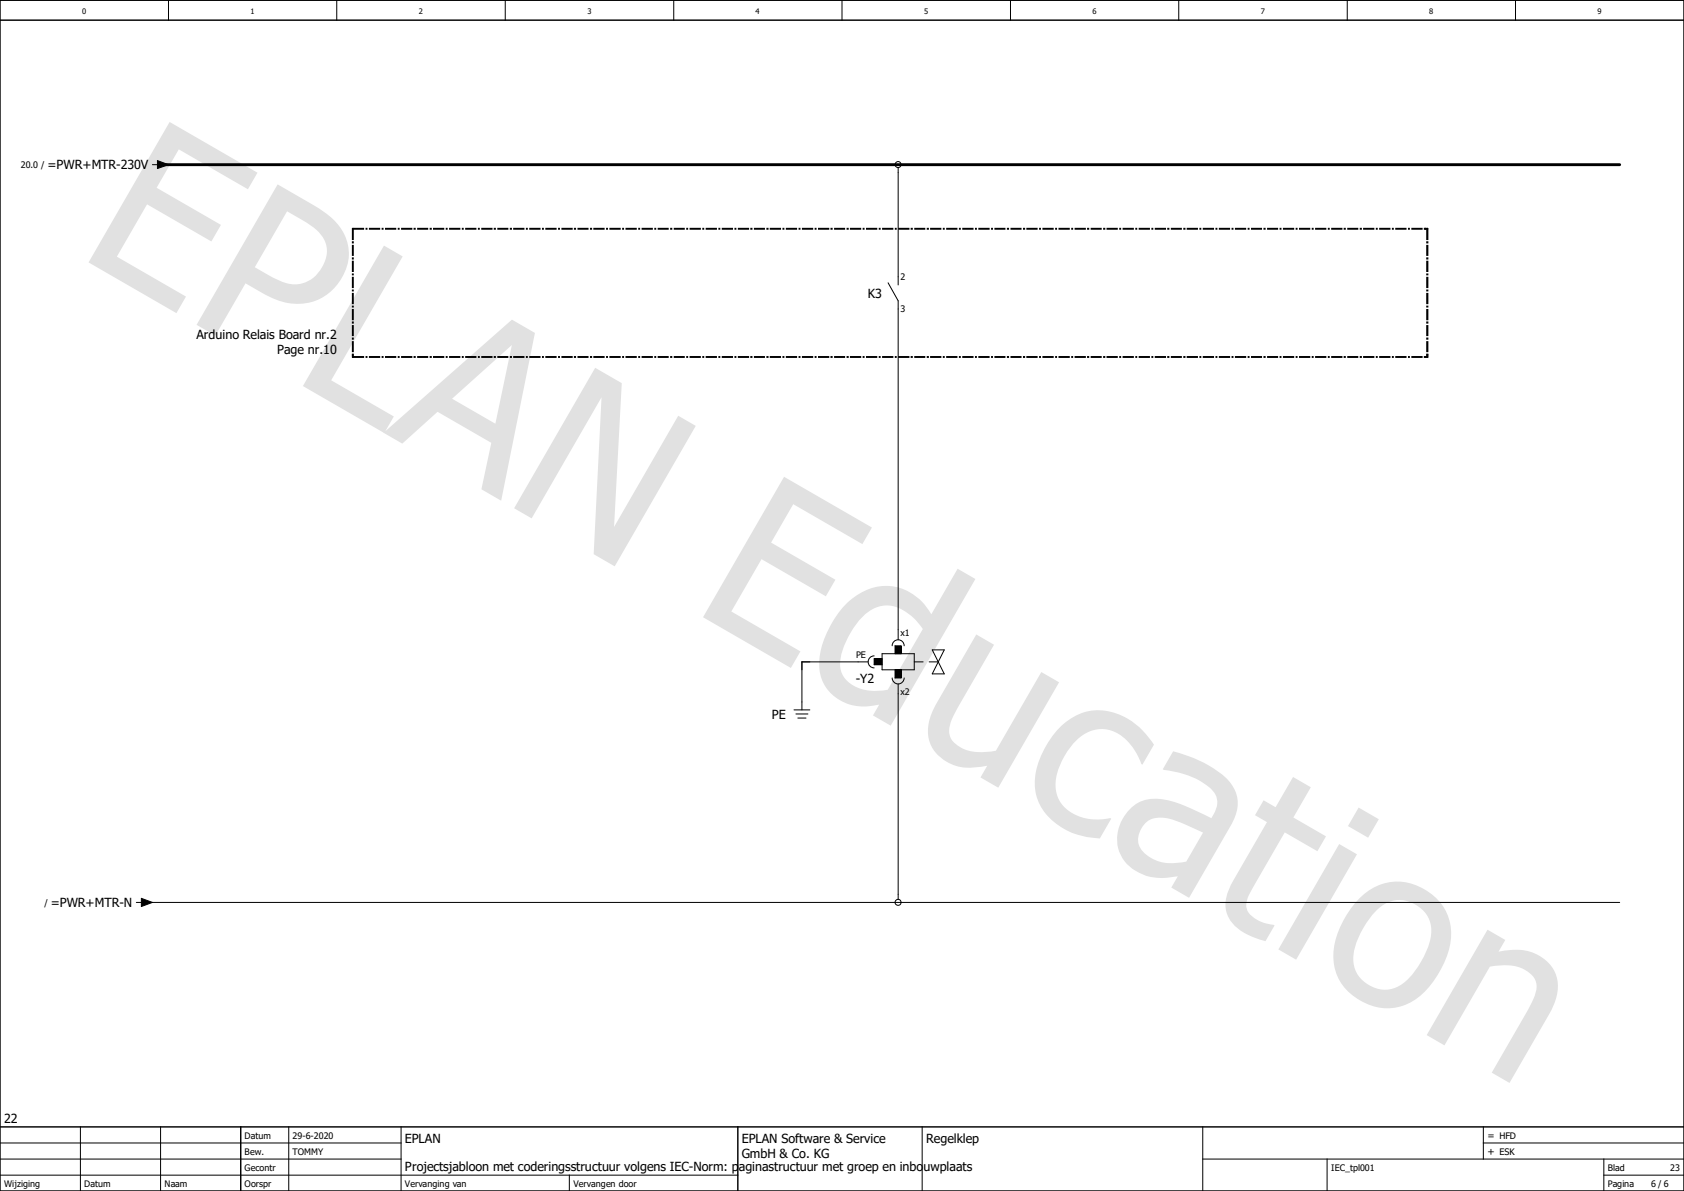
[picture p17: page 6]
Regelklep; Page nr.10; / =PWR+MTR-N; 20.0 / =PWR+MTR-230V

Arduino Relais Board nr.2
