MKEadmin/Vertical_farming/pcb/PCB.pdf

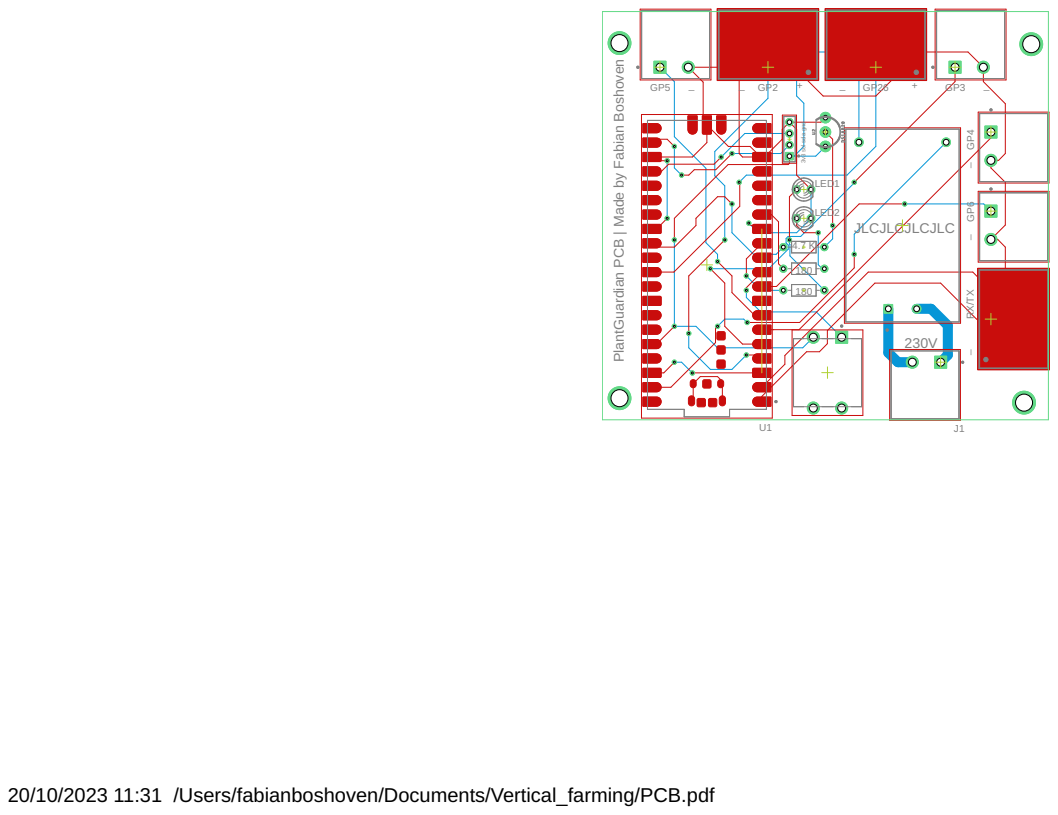
[picture p18: page 1]

PlantGuardian PCB | Made by Fabian Boshoven

20/10/2023 11:31 /Users/fabianboshoven/Documents/Vertical_farming/PCB.pdf
