MKEadmin/Vertical_farming/(commit log)

2023-09-14 Add files via upload
    added parts list for project
    [EDUTRANS Part List Vertical Farming.xlsx]
2023-09-27 added main code file for raspberry pi pico
2023-10-10 added v0.9 release for software
    contains mqtt code for publishing temp, humidity and air quality. Also receiving code for toggle the relay for the fan, led and water hoses
    Also added code for access point mode. Only needs work to add broker ip field on the access point website. This will be done in v1 release coming soon.
    [boot.py, main.py]
2023-10-20 Created pcb folder
2023-10-20 Created readme.md for pcb folder
2023-10-20 added schematic and pcb
2023-10-20 added Gerber files
2023-10-26 added fusion 360 pcb file for easy editing of the pcb
    [Vertical_farming_pcb.f3z]
2023-11-01 added v1.0
    New webpage design with post request instead of get request (safer) "note only use on mac or iphone because bug on windows and andriod due to many request from microsoft.com or google.com"
    added hardware.py to test sensors
    added more comments to make code more readable.
    [boot.py, hardware.py, main.py]
2023-11-05 Created readme.md for case
2023-11-05 added 3mf files for import into prusaslicer or cura
    [lidv1.3mf, vf-case.3mf]
2023-11-29 added files for release v1.9
    working code does run on current vertical farming installation
    bug:
    all relays turn on when first power. Need to modify wires and code for relay control
    [accesspoint.py, app_config.py, boot.py, hardware.py, main.py]
